VishKamath/siren-inr-asic-accelerator/doc/reconstructed_output 64n.png

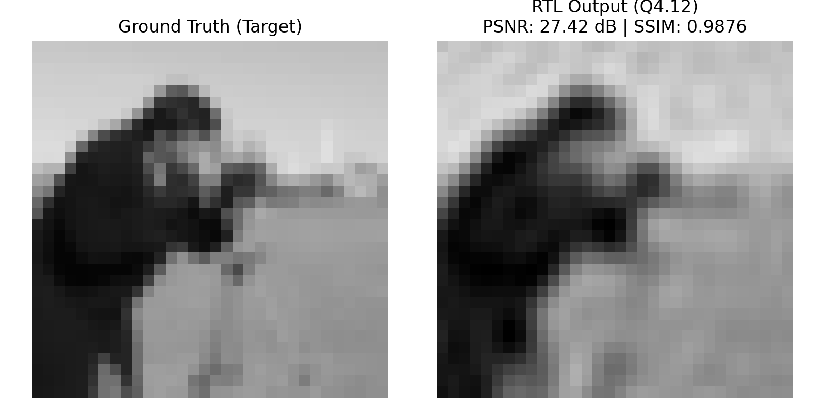
doc/reconstructed_output 64n.png
