VishKamath/siren-inr-asic-accelerator/doc/reconstructed_output.png

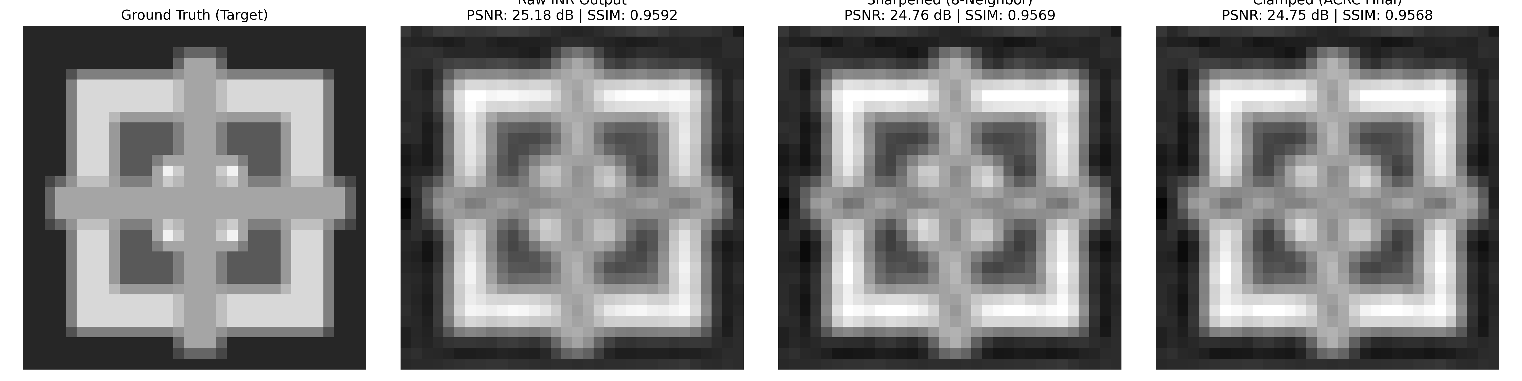
doc/reconstructed_output.png
