VishKamath/siren-inr-asic-accelerator/README.md

# `siren_block_engine`: Hardware Accelerator for Implicit Neural Representations

A high-throughput, pipelined ASIC accelerator engineered for **Implicit Neural Representations (SIREN)**, synthesized and closed for signoff using the Cadence digital implementation flow. The engine computes spatial affine mappings and continuous sinusoidal activations natively in silicon without lookup tables (LUTs) or software iteration stalls.

---

## 1. Architectural Overview

The core evaluates the canonical SIREN activation mapping:

$$y = \sin(\omega_0 \cdot (W \cdot x + b))$$

The engine features a 4-way parallel spatial execution array (`gen_physical_neurons[0..3]`), driven by a streaming, unrolled datapath designed for 100 MHz operation:

```
                     ┌──────────────────────────────────────────┐
                     │           w1_x_mem (Registers)           │
                     └────────────────────┬─────────────────────┘
                                          │ Input Coordinates & Weights
                                          ▼
                     ┌──────────────────────────────────────────┐
                     │     Stage 1: Affine Transform (MAC)      │
                     │   Carry-Save Adder (CSA) Trees & Accum   │
                     └────────────────────┬─────────────────────┘
                                          │ Raw Dot-Product (32-bit Q16.16)
                                          ▼
                     ┌──────────────────────────────────────────┐
                     │    Stage 2: siren_scaler & Remainder     │
                     │  Fixed-Point const_mul (ω0) & rem (mod 2π)│
                     └────────────────────┬─────────────────────┘
                                          │ Wrapped Angle θ
                                          ▼
                     ┌──────────────────────────────────────────┐
                     │         Stage 3: phase_folder            │
                     │    Quadrant Mapping to [-π/2, +π/2]      │
                     └────────────────────┬─────────────────────┘
                                          │ Folded Angle + Sign Bit
                                          ▼
                     ┌──────────────────────────────────────────┐
                     │     Stage 4: 16-Stage Unrolled CORDIC    │
                     │     Pipelined Shift-and-Add Vector Rot   │
                     └────────────────────┬─────────────────────┘
                                          │
                                          ▼
                             Final Activation Output y

```

### Key Sub-Blocks

* **Coordinate Affine Engine**: Compresses multi-operand additions using high-speed Carry-Save Adder (CSA) trees (`csa_tree_add_*`) and dedicated adders (`ADDFX1`, `ADDFXL`) to bypass long carry-propagation delays.

* **Frequency Scaler & Angle Modulo (`siren_scaler`)**: Applies the $\omega_0$ scaling factor via fixed-point multiplication (`const_mul_23_33_*`) and reduces angles via a modular remainder datapath (`rem_26_34_*`).

* **Phase Folder (`phase_folder`)**: Maps angles spanning arbitrary domains into the primary CORDIC convergence window $[-\pi/2, +\pi/2]$ and preserves sign symmetry flags.

* **16-Stage Unrolled CORDIC Pipeline (`sn_siren_act_u_cordic`)**: Computes trigonometric vector rotations using fixed elementary shifts ($2^{-i}$) and adder-subtractors, producing **4 parallel activations every clock cycle** after an initial fill.

---

## 2. Toolchain & Operating Environment

* **Logic Synthesis**: Cadence Genus™ Synthesis Solution (Release 21.14-s082_1)

* **Static Timing Analysis (STA)**: Cadence Tempus™ Timing Signoff Solution (Release 22.11-s001_1)

* **Physical Signoff**: Cadence Pegasus™ / Mentor Calibre (DRC/LVS/ERC)
* **Standard Cell Corner**: `slow` PVT operating conditions, balanced clock tree, enclosed wireload mode

* **Target Clock Constraint**: Single synchronous clock (`clk`), $T_{\text{period}} = 10.00\,\text{ns}$ ($100\,\text{MHz}$)

### 3. Synthesis Quality of Results (QoR)

Generated by Cadence Genus at the `slow` library corner:

#### Area & Instance Breakdown
| Cell Class | Instance Count | Total Area (um2) | Area Contribution |
| :--- | :--- | :--- | :--- |
| Combinational Logic | 22,770 | 157,283.817 | 62.7% |
| Sequential Logic | 3,984 | 87,925.287 | 35.0% |
| Inverters | 2,316 | 5,679.021 | 2.3% |
| Buffers | 4 | 18.166 | < 0.1% |
| **Total Engine Silicon** | **29,074** | **250,906.291** | **100.0%** |

#### Dominant Gate Families
* **Adders / Compressors (`ADDFX1`, `ADDFXL`, `ADDFHX1`)**: 2,826 instances (~55,599 um2) driving the CSA trees and CORDIC stages.
* **Complex Gates (`AOI21`, `AOI22`, `OAI21`, `OAI22`, `OAI2BB1`)**: 6,569 instances (~37,280 um2).
* **Multiplexers (`MXI2XL`, `MX2X1`, `CLKMX2`)**: 2,501 instances (~15,357 um2).
* **Registers (`DFFRHQX1`, `SDFFRHQX1`, `DFFRX1`, `SDFFRX2`)**: 3,984 instances (87,925 um2).
* **Simple Logic Gates (`NAND2XL`, `NOR2XL`, `AND2XL`, `INVX1`)**: 8,914 instances (~25,604 um2).

#### Synthesis Complexity & Run Metrics
* **Max Fanout**: 3,984 (Clock root `clk`)
* **Average Fanout**: 2.2
* **Terms-to-Net Ratio**: 3.155
* **Terms-to-Instance Ratio**: 3.942
* **Peak Memory Usage**: 2,456.75 MB
* **Synthesis Elapsed Runtime**: 804 seconds (~13.4 min)

---

### 4. Power Dissipation Analysis

Measured at 100 MHz, nominal VDD, and the `slow` PVT corner (Genus PDB frames):

| Category | Leakage (mW) | Internal (mW) | Switching (mW) | Total (mW) | Power Share |
| :--- | :--- | :--- | :--- | :--- | :--- |
| Sequential (Registers) | 0.478 | 8.726 | 0.407 | 9.610 | 47.94% |
| Combinational Logic | 0.689 | 6.312 | 3.435 | 10.437 | 52.06% |
| **Total Engine Dissipation** | **1.167 (5.82%)** | **15.038 (75.01%)** | **3.842 (19.17%)** | **20.047** | **100.0%** |

#### Power Characteristics
* **Internal Power Dominance (75.01%)**: Reflects high internal capacitive charging in the arithmetic carry chains and CORDIC shifter-adders.
* **Leakage Containment (5.82%)**: Static leakage is restricted to 1.17 mW under worst-case thermal and voltage conditions.

---

### 5. Signoff Static Timing Analysis (Tempus)

Multi-corner signoff completed in Cadence Tempus with zero violating paths across all checks:

#### Multi-Corner Slack Summary
| Analysis View / Check | WNS (ns) | TNS (ns) | Violating Paths (FEP) | Signoff Status |
| :--- | :--- | :--- | :--- | :--- |
| **Setup Signoff (worst_case)** | **+0.094** | **0.000** | **0** | **MET** |
| - reg2reg | +0.094 | 0.000 | 0 | MET |
| - in2reg | +0.112 | 0.000 | 0 | MET |
| - reg2out | +1.731 | 0.000 | 0 | MET |
| - in2out | +0.208 | 0.000 | 0 | MET |
| - Async Recovery | +4.683 | 0.000 | 0 | MET |
| **Hold Signoff (best_case)** | **+0.001** | **0.000** | **0** | **MET** |
| - reg2reg | +0.001 | 0.000 | 0 | MET |
| - in2reg | +0.654 | 0.000 | 0 | MET |
| - reg2out | +0.759 | 0.000 | 0 | MET |
| - in2out | +1.331 | 0.000 | 0 | MET |
| **Endpoint Min Pulse Width** | **+4.357** | **0.000** | **0** | **MET** |

#### Design Rule Violations (DRVs)
* **Max Transition**: 0 Violations (Clean)
* **Max Capacitance**: 0 Violations (Clean)
* **Max / Min Fanout**: 0 Violations (Clean)
*
---  
## 6. Critical Path Analysis

### 1. Setup Critical Path (WNS = +0.094 ns)

* **Startpoint**: `gen_physical_neurons[2].sn_mac_acc_out_reg[3]/CK` $\rightarrow$ `Q` (Launch: 0.049 ns)

* **Endpoint**: `gen_physical_neurons[2].sn_siren_s/data_out_reg[13]/D`

* **Logic Depth**: 73 cascaded combinational gates

* **Datapath Traversal**: Accumulator output feeding through constant multiplier logic (`const_mul_23_33_*`) into the modulo remainder chain (`rem_26_34_*`).

* **Timing Breakdown**:
* Data Arrival Time: $9.669\,\text{ns}$

* Required Time: $9.763\,\text{ns}$ (Clock Period: 10.000 ns, Library Setup: 0.137 ns, Uncertainty: 0.100 ns)

* **Slack Margin: +0.094 ns (MET)**

### 2. Hold Critical Path (WNS = +0.001 ns)

* **Startpoint**: `gen_physical_neurons[3]...gen_cordic_stages[10].u_stage_z_out_reg[9]/CK` $\rightarrow$ `QN`

* **Endpoint**: `gen_physical_neurons[3]...gen_cordic_stages[11].u_stage_z_out_reg[9]/D`

* **Timing Mechanism**: Back-to-back shift-register stages in the CORDIC array feature minimal logic delay, making them susceptible to hold contamination.

* **Resolution**: P&R inserted 61 ps delay cells (`DLY1X1`).

* Data Arrival Time: $0.212\,\text{ns}$

* Required Time: $0.210\,\text{ns}$

* **Slack Margin: +0.001 ns (MET)**

---

## 7. Physical Verification Checklist

Before tape-out generation, the post-route database is verified against the following rule matrix:

| Verification Stage | Check Item | Target Criterion | Status |
| --- | --- | --- | --- |
| **DRC (Design Rule Check)** | Base Layers (Poly, Well, Diffusion) | Spacing, enclosure, and width clean | Clean |
|  | Metal Interconnects (M1 - Top Metal) | Minimum width, pitch, and via enclosure | Clean |
|  | Antenna Ratio Violations | Diode insertion on long CORDIC routes | Clean |
|  | Metal / Poly Density Fill | Meets min/max density windows | Clean |
| **LVS (Layout vs. Schematic)** | Net Connectivity | Net mismatches = 0 | 100% Match |
|  | Device Integrity | Extracted MOS/Cap/Res count matches netlist | 100% Match |
|  | Short & Open Circuits | Shorts = 0, Opens = 0 | Clean |
|  | Substrate & Well Taps | Tap integrity and latch-up rules verified | Clean |
| **ERC & Reliability** | Well Biasing | No floating wells or unstrapped cells | Clean |
|  | Static IR Drop | Max drop $< 2.5\%$ of nominal $V_{\text{DD}}$ | Clean |
|  | Electromigration (EM) | Power straps within peak current budgets | Clean |

---

## 8. Directory Structure

```
├── rtl/
│   ├── siren_block_engine.sv          # Top-level accelerator module
│   ├── csa_tree_add.sv                # Carry-Save Adder tree compressor
│   ├── siren_scaler.sv                # ω0 multiplier & modulo remainder datapath
│   ├── phase_folder.sv                # Quadrant folding to [-π/2, +π/2]
│   └── cordic_stage.sv                # Pipelined unrolled CORDIC vector rotation
├── constraints/
│   └── signoff_generated.sdc          # Synthesis & STA clock/delay constraints
├── reports/
│   ├── genus/
│   │   ├── area_report.rpt            # Cell count, hierarchical area breakdown
│   │   ├── gates_report.rpt           # Standard cell library gate distribution
│   │   ├── power_report.rpt           # Dynamic internal/switching & leakage power
│   │   └── qor_report.rpt             # Quality of results, fanout, runtimes
│   └── tempus/
│       ├── timing_summary.rpt         # Path-group WNS/TNS/FEP signoff table
│       ├── setup_signoff.rpt          # Top 20 setup critical path traces
│       ├── hold_signoff.rpt           # Top 20 hold critical path traces
│       └── all_violators.rpt          # DRV, transition, capacitance, fanout checks
└── docs/
    ├── siren_master_review.html       # 17-slide interactive review deck
    └── technical_handbook.md          # Comprehensive architecture handbook

```

---

## 9. Key Signoff Metrics Summary

* **Target Clock Frequency**: 100 MHz ($T = 10.00\,\text{ns}$)

* **Total Cell Count**: 29,074 standard cells

* **Silicon Core Area**: 250,906.291 $\mu\text{m}^2$ ($0.251\,\text{mm}^2$)

* **Total Power Consumption**: 20.047 mW (Slow corner signoff)

* **Setup WNS**: **+0.094 ns** (0 failing endpoints)

* **Hold WNS**: **+0.001 ns** (0 failing endpoints)

* **Design Rule Violations (DRVs)**: 0 (Transition, Capacitance, and Fanout clean)
