VishKamath/siren-inr-asic-accelerator/doc/astronaut.png

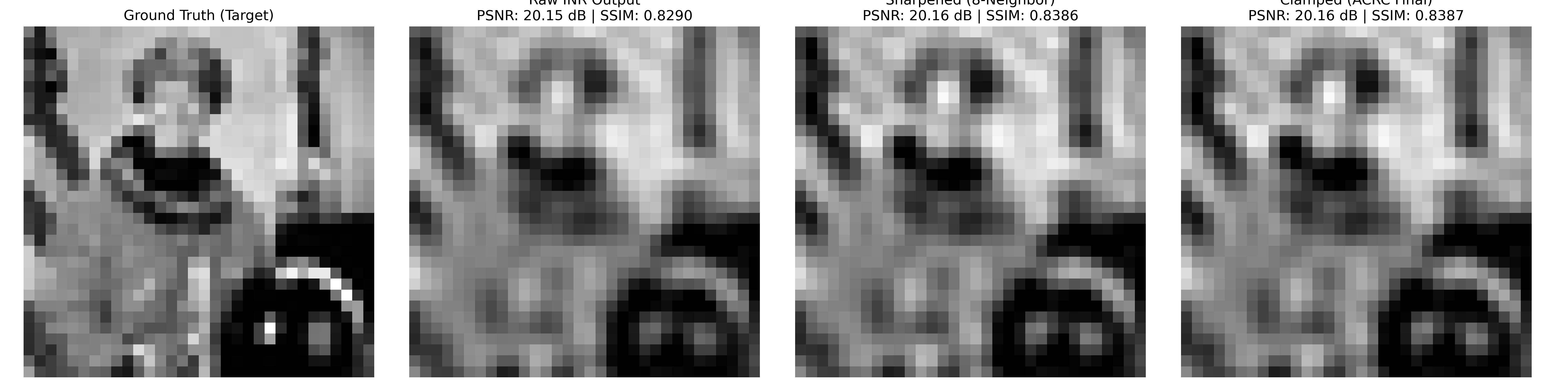
doc/astronaut.png
