VishKamath/siren-inr-asic-accelerator/doc/cameraman.png

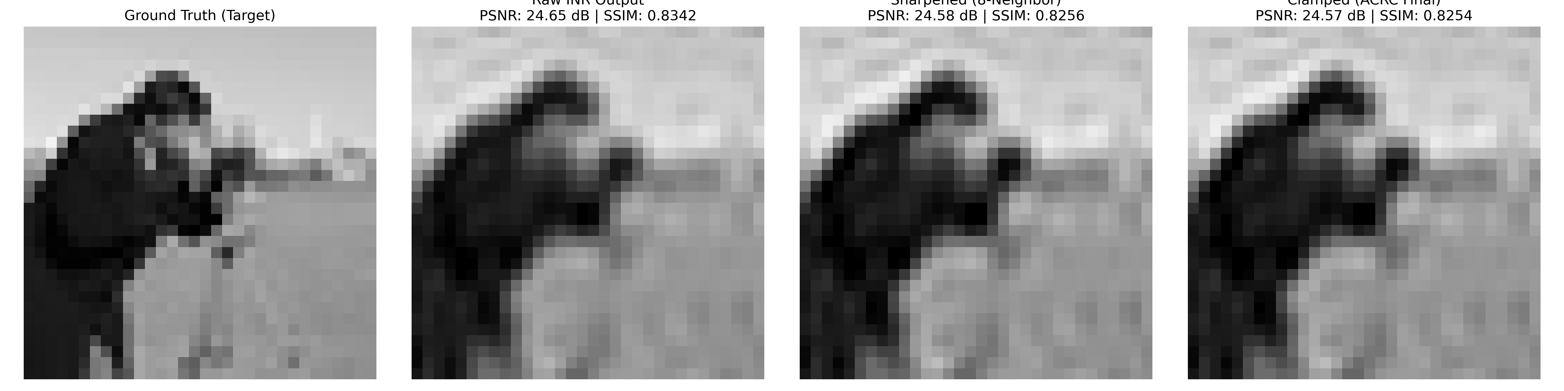
doc/cameraman.png
