VishKamath/siren-inr-asic-accelerator/doc/clock.png

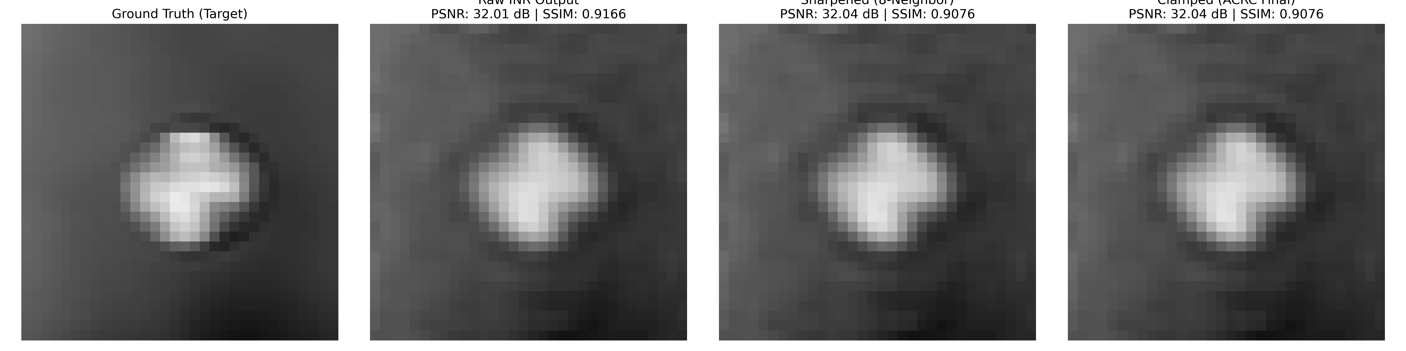
doc/clock.png
