VishKamath/siren-inr-asic-accelerator/doc/ic_layout.png

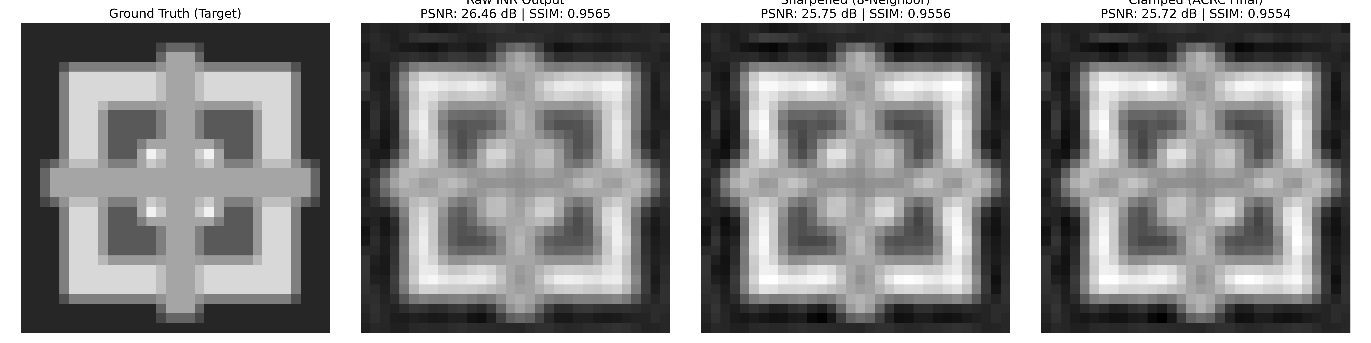
doc/ic_layout.png
