VishKamath/siren-inr-asic-accelerator/doc/moon.png

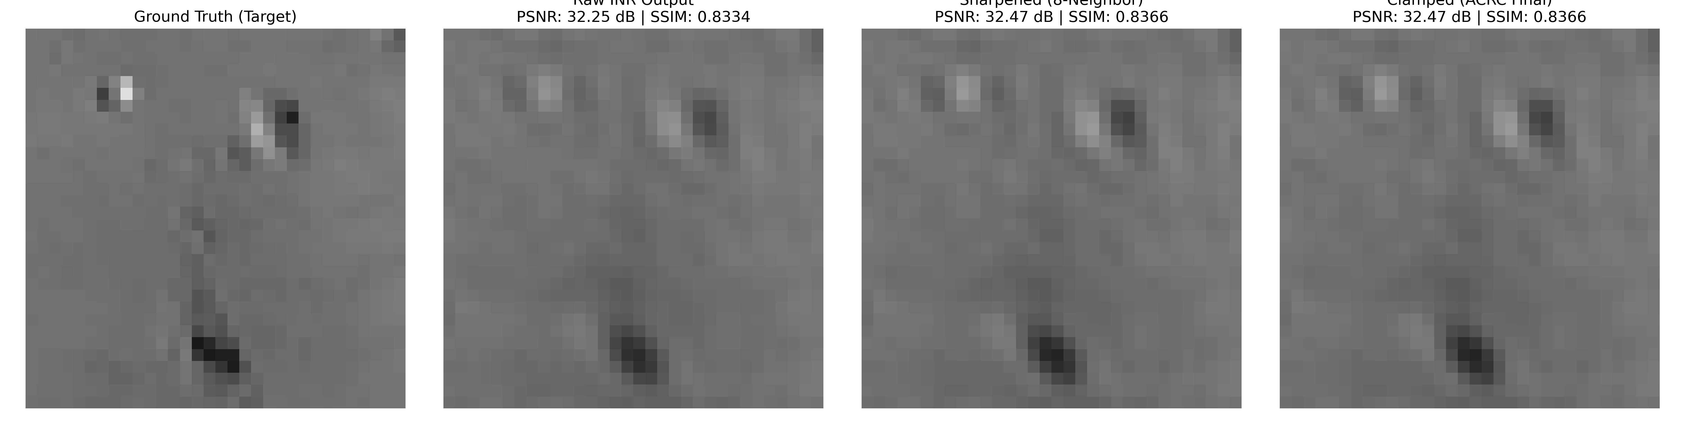
doc/moon.png
