VishKamath/siren-inr-asic-accelerator/doc/siemens_star.png

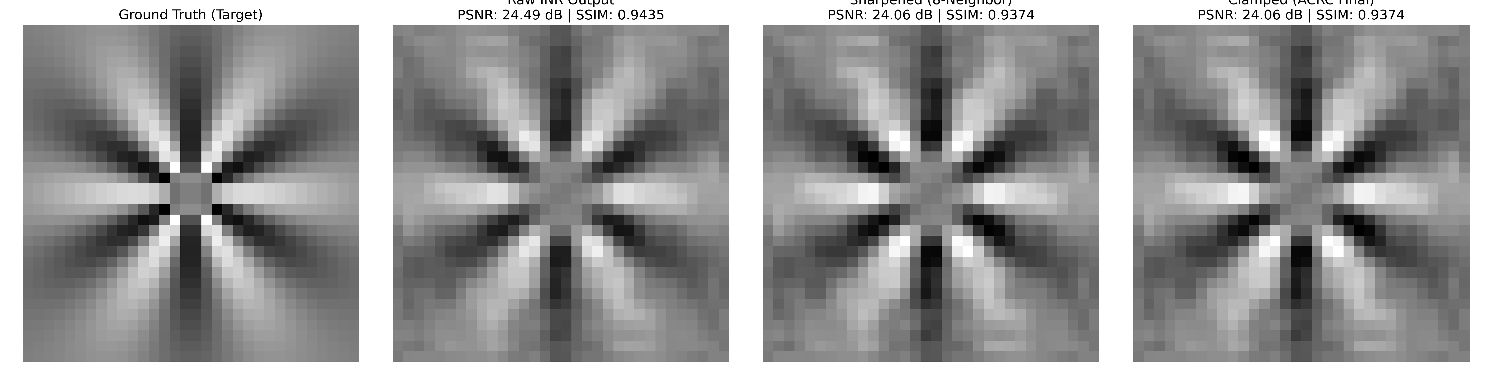
doc/siemens_star.png
