VishKamath/siren-inr-asic-accelerator/doc/zone.png

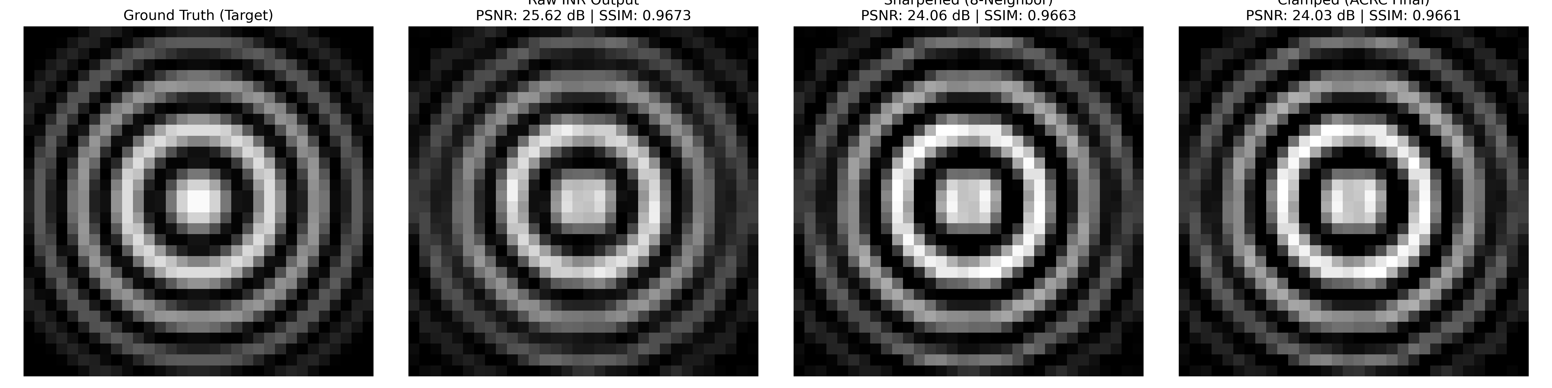
doc/zone.png
