VishKamath/siren-inr-asic-accelerator/doc/reconstructed_output64n.png

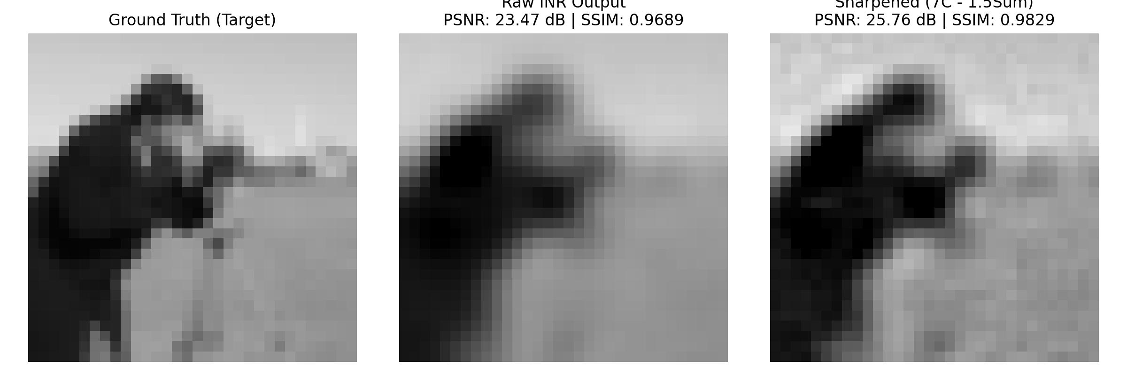
doc/reconstructed_output64n.png
