VishKamath/siren-inr-asic-accelerator/doc/reconstructed_output (Copy).png

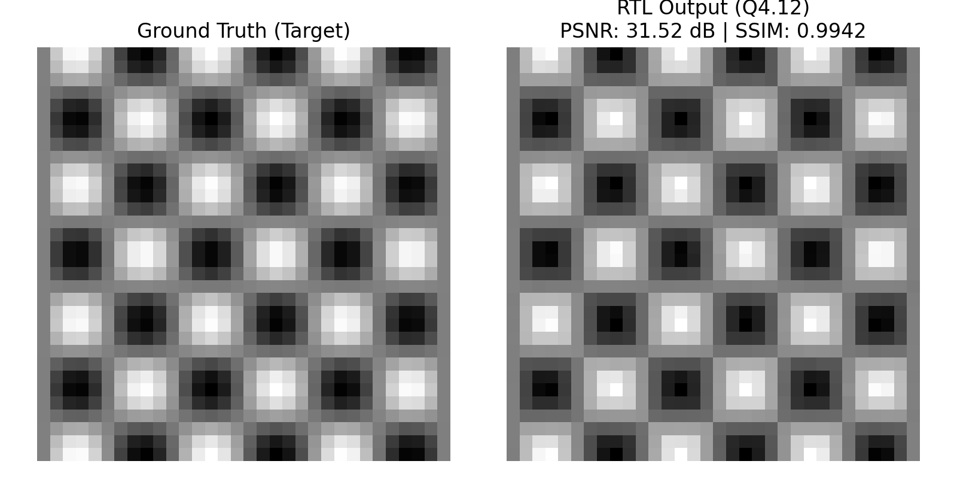
doc/reconstructed_output (Copy).png
