VishKamath/siren-inr-asic-accelerator/reconstructed_output.png

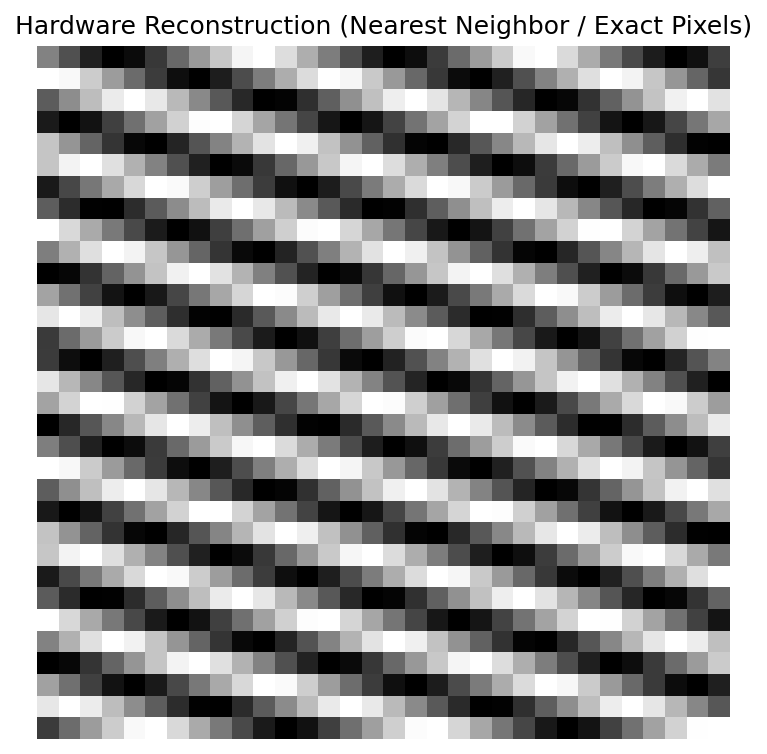
reconstructed_output.png
