VishKamath/siren-inr-asic-accelerator/doc/reconstructed_output_test.png

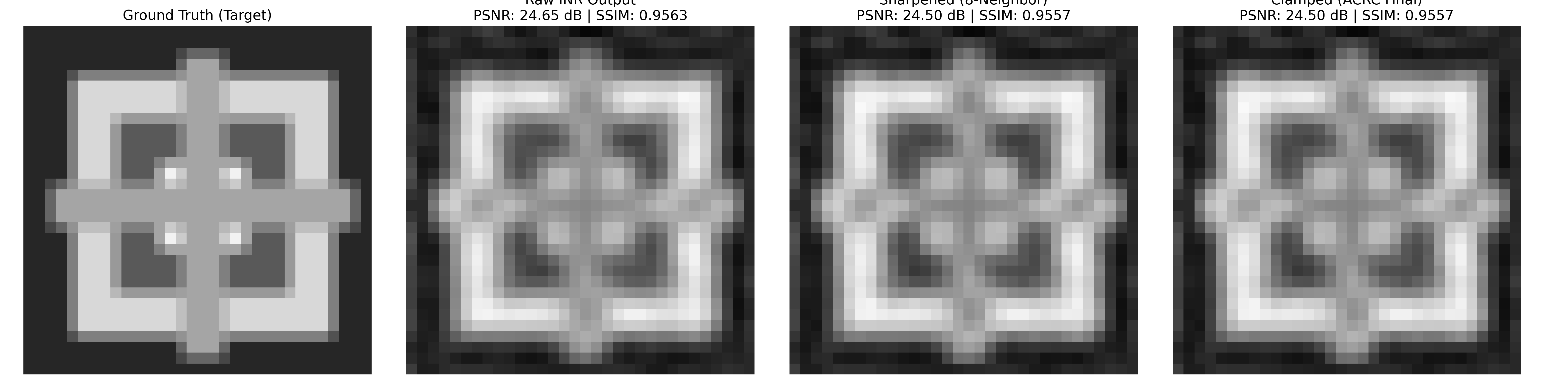
doc/reconstructed_output_test.png
