VishKamath/siren-inr-asic-accelerator/(commit log)

2026-10-09 fix(engine): align 20-cycle pipeline and resolve pass 7 truncation for bit-exact 25.09 dB PSNR
    [cordic_stage.sv, mac_unit.sv, siren_block_engine.sv, siren_scaler.sv]
2026-10-10 Update 64-neuron folded block engine, 8-neighbor sharpen filter, and evaluation scripts
